aw58/HMSU2/FinalDownloadables/README

These files are necessary for the operation of the HMSU2 system. 
"Interface.cs" - the main Unity script for controlling data acquisition and use.
"ChangeColor.cs" - a supporting scrupt which allows for interactable targets in the game space
"Serial_Quat_and_Accel_Huzzah.ino" - code to be uploaded to the Adafruit Feather Huzzah for serial data transfer

These files are for expansion upon the current system:
"Huzzah_wifi_send_game_and_accel.ino" - code to be uploaded to the Huzzah to send data over wifi, to be paired with...
"InputController.cs" - Unity script for listening to a server at the Huzzah's IP address

FULL UNITY APPLICATION ZIP:
https://pitt-my.sharepoint.com/:u:/g/personal/aaw58_pitt_edu/EerNpHu7o6ZLvB9tCeGkgX0BTBuhmSAYk2-JKrGQt5WVmQ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
