aw58/HMSU2/(list of files, cad)

Other CAD files:
FinalDownloadables/Final HMSU Case Design.f3z
