aw58/HMSU2/Documentation/Case Bottom Drawing.pdf

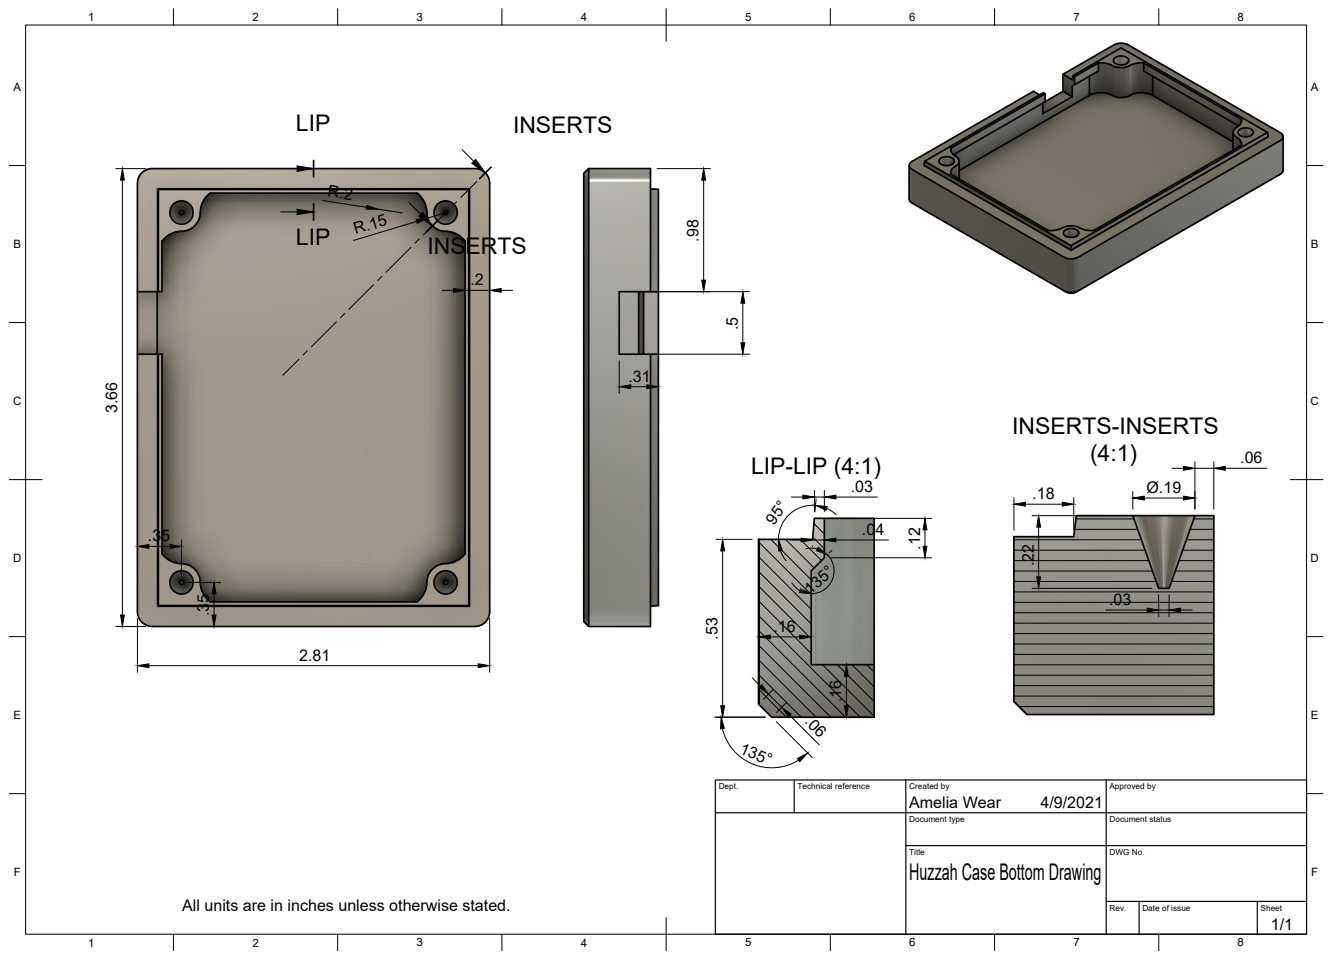
[picture p1: page 1]
Title; DWG No.; Rev.; Date of issue; Sheet; LIP-LIP (4:1) .16

Dept. | Technical reference | Created by Amelia Wear 4/9/2021 | Approved by

Document type | Document status

Huzzah Case Bottom Drawing

All units are in inches unless otherwise stated.
