aw58/HMSU2/ArduinoMKRDataTransfer/WiFiServer/WiFiServer.ino

#include <SPI.h>
#include <WiFiNINA.h>
#include <MKRIMU.h>

char ssid[] = "SlamDunksOnly";          //  your network SSID (name)
char pass[] = "PFCPelkington";   // your network password
int status = WL_IDLE_STATUS;

IPAddress ip(192,168,1,231);
IPAddress gateway(192,168,1,1);
IPAddress subnet(255,255,255,0);

WiFiServer server(80); //sets up port: 5001 as TCP socket port
WiFiClient client; //estables a client connection



void setup() {

  //Initialize serial and wait for port to open:
  Serial.begin(9600);
  while (!Serial);// wait for serial port to connect. Needed for native USB port only
  
  if(!IMU.begin())
  {
    Serial.println("Failed to initalize IMU!");

    while(1);
  }
  else
  {
    Serial.println("IMU initialized!");
  }

  Serial.print("Accelerometer sample rate = ");
  Serial.print(IMU.accelerationSampleRate());
  Serial.println(" Hz");
  Serial.print("Gyroscope sample rate = ");
  Serial.print(IMU.gyroscopeSampleRate());
  Serial.println(" Hz");
//  Serial.print("Magnatometer sample rate = ");
//  Serial.print(IMU.magneticFieldSampleRate());
//  Serial.println(" Hz");

  Serial.println("Attempting to connect to WPA network...");
  WiFi.begin(ssid, pass);
  WiFi.config(ip, gateway, subnet);
  
  if ( WiFi.status() != WL_CONNECTED) {
    Serial.println("Couldn't get a wifi connection");
    while(true);
  }
  else {
    Serial.print("Connected to wifi. My address:");
    IPAddress myAddress = WiFi.localIP();
    printWiFiStatus();
    server.begin();
  }
  
}

void loop() {
  client = server.available();

  float aX, aY, aZ;
  float gX, gY, gZ;
  float mX, mY, mZ;

  if(client)
  {
    Serial.println("Client Connected");
    while(client.connected())
    {

      if(IMU.accelerationAvailable())
      {
        IMU.readAcceleration(aX, aY, aZ);
        
        Serial.print("Accel Data:\t");
        Serial.print(aX);
        Serial.print(',');
        Serial.print(aY);
        Serial.print(',');
        Serial.println(aZ);

        client.print("Accel Data:\t");
        client.print(aX);
        client.print(',');
        client.print(aY);
        client.print(',');
        client.print(aZ);   
        client.print('\r');    
      }

     if(IMU.gyroscopeAvailable())
      {
        IMU.readGyroscope(gX, gY, gZ);

        Serial.print("Gyro Data:\t");
        Serial.print(gX);
        Serial.print(',');
        Serial.print(gY);
        Serial.print(',');
        Serial.println(gZ);

        client.print("Gyro Data:\t");
        client.print(gX);
        client.print(',');
        client.print(gY);
        client.print(',');
        client.print(gZ);   
        client.print('\r');    
      }
      
//    if(IMU.magneticFieldAvailable())
//      {
//        IMU.readMagneticField(mX, mY, mZ);
//
//        Serial.print("Mag Data:\t");
//        Serial.print(mX);
//        Serial.print('\t');
//        Serial.print(mY);
//        Serial.print('\t');
//        Serial.println(mZ);
//
//        client.print("Mag Data:\t");
//        client.print(mX);
//        client.print('\t');
//        client.print(mY);
//        client.print('\t');
//        client.print(mZ);   
//        client.print('\r');    
//      }

      delay(1);
    }
  }
}

void printWiFiStatus() {
  // print the SSID of the network you're attached to:
  Serial.print("SSID: ");
  Serial.println(WiFi.SSID());

  // print your board's IP address:
  IPAddress ip = WiFi.localIP();
  Serial.print("IP Address: ");
  Serial.println(ip);

  // print the received signal strength:
  long rssi = WiFi.RSSI();
  Serial.print("signal strength (RSSI):");
  Serial.print(rssi);
  Serial.println(" dBm");
}
