aw58/HMSU2/(commit log)

2021-03-12 Add files via upload
    Initial prototype code >> includes color-changing ball script, and Arduino/Unity scripts for sending and receiving messages.
2021-03-19 Add files via upload
    All files required for setting up basic sense ==> gyro ==> cursor orientation (with environment interaction working normally).
2021-04-09 Add files via upload
    Add final case design.
    [Final HMSU Case Design.f3z]
